sabrinachowdhuryoshin/Microcontroller-Based-Voltage-Stabilizer/final_code/final_code.ino

int acval = 0;
int relay1 = 3;
int relay2 = 4;
int relay3 = 5;
int relay4 = 6;
int relay5 = 7;

void setup() {
Serial.begin(9600);
Serial.println("meaw");
pinMode(relay1, OUTPUT);
pinMode(relay2, OUTPUT);
pinMode(relay3, OUTPUT);
pinMode(relay4, OUTPUT);
pinMode(relay5, OUTPUT);
digitalWrite(relay1, 1);
digitalWrite(relay2, 1);
digitalWrite(relay3, 1);
digitalWrite(relay4, 1);
digitalWrite(relay5, 1);
}

void loop() {
acval = analogRead(A0);
Serial.print("AC analog VALUE
");
Serial.print(acval);
Serial.println("");
delay(100);
if ( acval <= 263)
{
Serial.println("Voltage is
less than 130V ");
digitalWrite(relay1, 1);
digitalWrite(relay2, 1);
digitalWrite(relay3, 1);
digitalWrite(relay4, 1);
digitalWrite(relay5, 1);
}
else if (acval >= 263 && acval <= 283)
{
Serial.println("Voltage is
around 130V ");
digitalWrite(relay1, 1); //
tapper 1
digitalWrite(relay2, 1); //
tapper 2
digitalWrite(relay3, 1);
//170 >>192.4 tapper3
digitalWrite(relay4, 1); //
tapper 4
digitalWrite(relay5, 1); //
tapper 5
}
else if (acval >= 293 && acval <= 306)
{
Serial.println("Voltage is
around 140V ");
digitalWrite(relay1, 1); //
tapper 1
digitalWrite(relay2, 1); //
tapper 2
digitalWrite(relay3, 1);
//170 >>192.4 tapper3
digitalWrite(relay4, 1); //
tapper 4
digitalWrite(relay5, 1); //
tapper 5
}
else if (acval >= 313 && acval <=
335)
{
Serial.println("Voltage is
around 150V ");
digitalWrite(relay1, 1); //
tapper 1
digitalWrite(relay2, 1); //
tapper 2
digitalWrite(relay3, 1);
//170 >>192.4 tapper3
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
}
else if (acval >= 580)
{
Serial.println("Voltage is
more than 230V .Warning!! ");
digitalWrite(relay1, 1); //
tapper 1
digitalWrite(relay2, 1); //
tapper 2
digitalWrite(relay3, 1);
//170 >>192.4 tapper3
digitalWrite(relay4, 1); //
tapper 4
digitalWrite(relay5, 1); //
tapper 5
}
