sabrinachowdhuryoshin/Microcontroller-Based-Voltage-Stabilizer/(commit log)

2021-03-10 This is the voltage sampling code
2021-03-11 voltage_sampling folder is created
